Esp3ra/2026-Moble-2.5th-Team-Project-/docs/breadboard-power-example.png

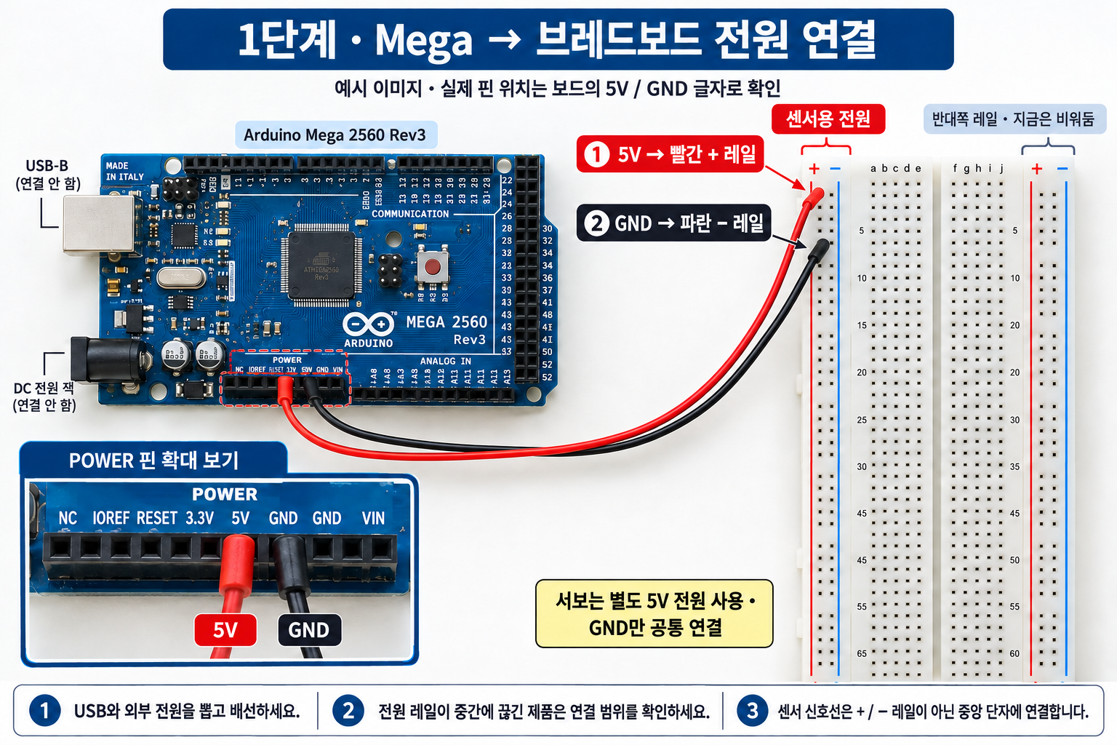
docs/breadboard-power-example.png
