Esp3ra/2026-Moble-2.5th-Team-Project-/artifacts/temperature-stop-dashboard.png

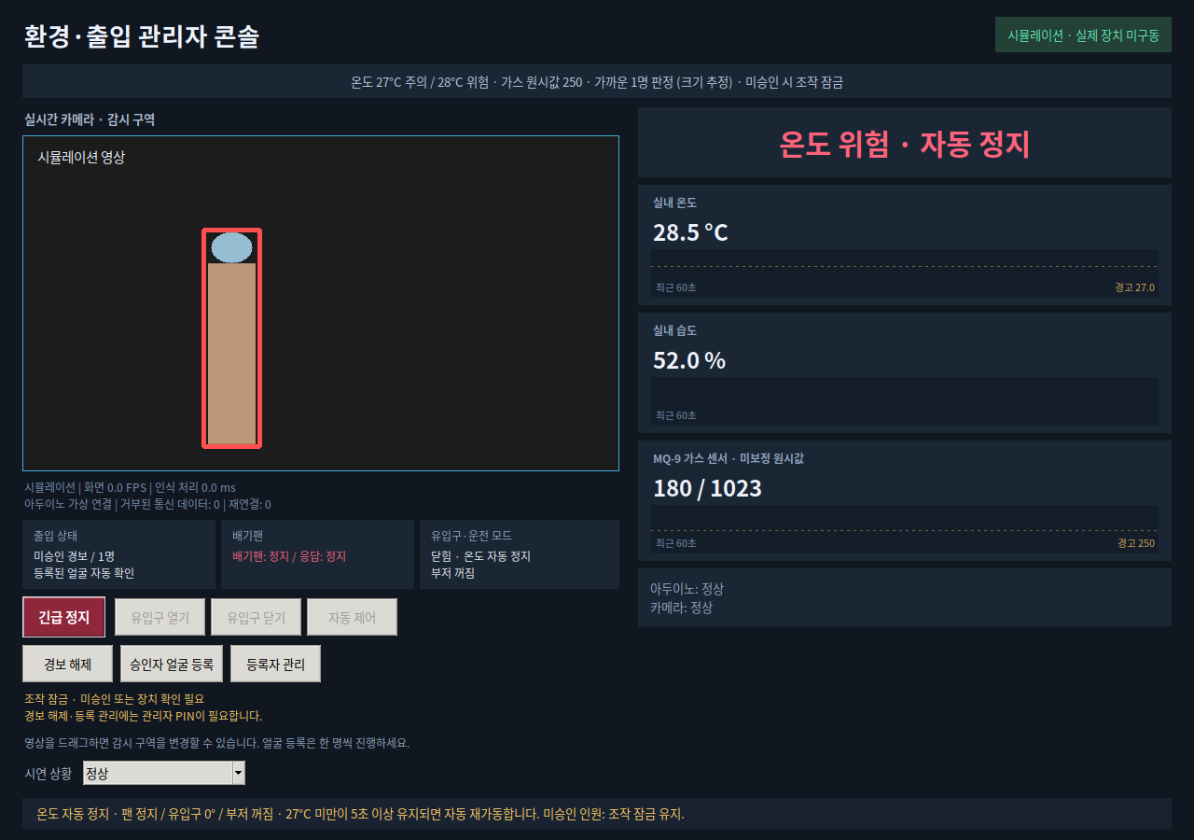
artifacts/temperature-stop-dashboard.png
