Esp3ra/2026-Moble-2.5th-Team-Project-/docs/VALIDATION.md

# 소프트웨어 검증 결과

## 현재 버전: 온도 자동 정지·복귀 (정책 6, 2026-10-15)

- 자동 테스트 **123개 통과**: 28°C 자동 정지, 27°C 미만 5초 유지 후 복귀, 재상승·센서/통신 이상 시 복귀 대기 재설정, 수동 긴급 정지·장치 오류 정지 유지, 가스·미승인 동시 발생, MCU와 호스트의 정지 응답 구분을 포함한다.
- Mega 컴파일·업로드와 정책 6 텔레메트리 확인 완료. Flash 24,578 bytes, 전역 RAM 1,913 bytes.
- 실제 보드 명령 시험: 기본 운전, 온도 자동 정지 출력, 미승인 잠금과 동시 정지, 운전 복귀, 수동 정지, 통신 중단 시 차단을 확인했다. 프레임 오류 0개. 이 시험은 명령·출력 응답 검증이며 실제 가열로 임계값을 넘기는 시험과 구분한다.
- 실제 센서·카메라·명령 응답 30.1초 관찰: 상태 30개, 오류·추가 거부 패킷·재연결 모두 0개. 수동 긴급 정지 상태에서 관찰했다.
- [자동 테스트](../artifacts/temperature-stop-tests.log), [출력 시험](../artifacts/temperature-stop-serial-result.json), [연결 관찰](../artifacts/temperature-stop-live.json), [합성 화면](../artifacts/temperature-stop-dashboard.png).
- DHT11 값이 튀는 물리적 원인은 미확정이다. 아래 항목은 이전 버전의 검증 이력이며 현재 동작은 [운영 안내](VENTILATION.md)를 따른다. 과거 전체 진단 원본은 Jetson에 보관하고, GitHub에는 개인정보 검토를 마친 최신 기록만 포함한다.

## 2026-10-15 부저 음량 감소

- 사용자의 음량 감소 요청에 따라 현재 ventilation 부저를 Timer3 구동으로 변경했습니다. 17% 듀티 시험에서 여전히 크다는 사용자 피드백을 받아 **5% 듀티**로 추가 감소했습니다. 사이렌 주파수와 경보 패턴은 유지합니다. 전기적 기본 주파수 성분의 이론적 진폭은 원래 50% 듀티의 약 16%이며 실제 체감 음량이나 dB 측정값은 아닙니다.
- 자동 검사 **102개 통과** (`quiet-buzzer-tests.log`). 새 검사는 100~8000Hz의 주파수 오차·펄스 폭, 실제 타이머 코드의 정지·재시작, 재설정 시 카운터 초기화, 부저 외 포트 비트 보존, Servo compare A 인터럽트 미사용을 확인합니다. 실제 MCU의 물리 파형을 계측한 검사는 아닙니다.
- Mega 빌드·업로드 완료: flash 23,836 bytes, static RAM 1,823 bytes (`quiet-buzzer-build.log`, `quiet-buzzer-upload.log`).
- 실제 부저를 3초간 시험했습니다. D10 OFF·D9 CLOSED를 유지한 상태에서 명령 응답을 확인했습니다 (`quiet-buzzer-serial.json`). 첫 17% 설정은 사용자에게 여전히 크게 들렸습니다 (`quiet-buzzer-serial-17pct.json`). 추가로 낮춘 **5% 설정은 사용자가 “이제 적당함”으로 확인**했습니다.
- 재연결 중 카메라 장치가 video0에서 video1로 바뀌어 첫 연속 검사에서 영상 연결에 실패했습니다 (`quiet-buzzer-live-before-camera-fix.json`). 운영 설정을 해당 USB 카메라의 `/dev/v4l/by-id/…-video-index0` 경로로 바꿔 장치 번호 변경에 대응합니다.
- 프로그램은 `--start-stopped`로 다시 열어 기존 긴급 정지를 유지합니다. 이 시작 옵션은 시뮬레이션에서 D10 OFF·D9 CLOSED·부저 OFF로 확인했습니다. 수정 후 실제 카메라·센서·명령 응답을 **30.1초** 확인했고 오류·거부 패킷·재연결이 모두 0개였습니다 (`quiet-buzzer-live.json`). 프로그램 재시작 후 저장된 얼굴로 AUTHORIZED 판정이 다시 발생하는 것도 기록에서 확인했습니다.

## 2026-10-15 관리자 콘솔·얼굴 승인·정책 버전 3

- 바탕화면 요청 파일의 네 가지 자동 상태, 정상 D9 0°, 경고 D9 90°, 미승인 초록/빨강, 동시 주황/빨강, 긴급 정지 D9 0°·D10 OFF를 반영했습니다. 관리자 UI는 한글, LCD는 영어입니다.
- 자동 검사 **101개 통과** (`artifacts/admin-tests.log`): 등록 데이터 재로드·삭제·저장 실패 보존, 품질 표본 등록, 모든 인원 확인, 얼굴 교체·추가 인원·오래된 영상 승인 차단, 경보음 해제와 새 원인 재경보, 수동 개폐·자동 복귀·긴급 정지, 기존 통신·카메라·SSD 회귀 검사 포함.
- 실제 Tk 위젯 검사 통과: 한글 PIN 확인/취소, 미승인 잠금, 경보 해제 버튼 활성, 유입구 닫기·얼굴 등록·관리 버튼, 센서 그래프와 잘못된 데이터의 끊김. `admin-ui-check.log`, `admin-ventilation-gui-check.log`, `admin-general-gui-check.log`. 화면 캡처는 시뮬레이션입니다.
- AVR 컴파일 통과: flash 25,014 bytes, static RAM 1,834 bytes. 실제 Mega 업로드 완료 (`admin-firmware-build.log`, `admin-firmware-upload.log`).
- 실제 Mega 출력 순서 시험 통과: ARM, 정상 저속, 미승인 저속, 환경 고속, 동시 고속, 경보음 해제, 긴급 정지, 수동 열기·닫기, 자동 복귀, 오류 정지. 모든 단계에 5회 이상 일치 ACK, 잘못된 프레임 0개, 명령 중단 시 MCU 독립 정지 확인. `admin-serial-result.json`. 이 결과는 출력 명령·응답 검증이며 이번 버전의 LED 색·축 움직임 육안 확인을 대신하지 않습니다.
- 실제 관리자 화면 + 센서 + GPU 카메라 **60.5초**, 상태 60개, 건강 상태 오류 0개, 추가 거부 패킷 0개, 추가 재연결 0개 (`admin-live-result.json`). 해당 구간은 미승인 상태였고 LOW/OFF 명령과 응답이 기록됐습니다.
- 위 구간 이후 14:46:57 카메라 작업이 한 번 재시작됐고 14:47:11 자동 복구됐습니다. 해당 로그만으로 종료 원인을 특정할 수는 없습니다. 복구 후 추가 **60.2초** 검사에서 오류·통신 거부·재연결 0개 (`admin-live-followup.json`), 긴급 정지 D10 OFF 유지가 확인됐습니다. 전체 실행에 카메라 중단이 전혀 없었다는 의미는 아닙니다.
- 사람+얼굴 GPU 모델을 켠 헤드리스 카메라 20초: 640×480, 영상 수신 **29.61fps**, 분석 **12.12회/초**, 분석 중앙값 **67.71ms** (`admin-face-camera-check.json`). 실제 Tk 표시 FPS 및 얼굴 인식 정확도 측정과 구분합니다.
- 사용자가 **얼굴 등록 완료 후 자동 승인**, **LCD 영어 상태와 LED·서보 동작 일치**를 확인했습니다. 실시간 상태에서도 AUTHORIZED가 확인됐습니다. 등록자 1명의 DB 파일(권한 0600)을 별도 Python 프로세스로 다시 읽어 저장 상태를 확인했습니다. 전체 운영 프로그램을 재시작한 뒤의 실물 자동 승인은 아직 재시험하지 않았습니다. 기록: `artifacts/admin-user-acceptance.json`. 등록 원본 사진을 저장하지 않으며 등록 DB와 PIN은 배포 ZIP에서 제외합니다. 얼굴 임계값의 실제 환경 오승인·오거부율이나 사진/영상 위조 방지는 검증하지 않았습니다.

검증일: 2026년 10월 14일. NVIDIA Jetson Nano B01, Ubuntu 18.04.6, ARM64, L4T 32.7.1 환경에서 실행했습니다.

| 항목 | 결과 |
|---|---|
| 자동 테스트 | 73개 통과. 경보·승인·시리얼·카메라 복구, SSD 관련 모의 테스트, 실제 C++ 출력 정책 및 bench 10초 제한·프로필 분리·PIN 저장·ACK 유효기간 테스트 포함 |
| 실제 Tk 화면 | 시뮬레이션 입력으로 정상 → 시작 → 침입 → 차단 → 임시 승인 → 명시적 재시작 흐름 통과 |
| Arduino 기본 펌웨어 | 최신 production 기본 설정 CLI 컴파일 통과. 플래시 16,372바이트, 전역 RAM 1,283바이트. 미확인 출력은 비활성 |
| 이전 출력 진단 단계의 활성화 빌드 | IR 제외, 회전 서보·2kHz 부저 포함 컴파일 통과. 당시 플래시 20,704바이트, 전역 RAM 1,387바이트. 이 기록은 최신 bench 빌드가 아님 |
| Arduino 실물 연동 펌웨어 | 최신 bench 빌드·USB 업로드 통과. 플래시 22,212바이트, 전역 RAM 1,472바이트. MCU 독립 10초 제한, DHT/LCD 작업 후 명령 수신 적용 |
| Arduino 센서 진단 | IDE로 실제 Mega 업로드 통과. 플래시 13,548바이트, 전역 RAM 729바이트. IR과 출력 비활성 |
| 실물 센서·LCD | 첫 수신 DHT11 약 26.4°C / 25.7–25.8% RH, A0 31–32, LCD 주소 0x27. 사용자가 LCD 글자 표시 확인 |
| IR 제외 후 재확인 | DHT11 25.4°C / 28.5% RH, A0 36, LCD 0x27, IR 미사용 패킷 수신. A0 수신은 가스 검출 검증이 아님 |
| RGB 실제 출력 | 사용자가 공통 음극·내장 저항칩 확인. 빨강 → 초록 → 파랑 → 노랑 → 꺼짐 모두 사용자 확인으로 통과. 이후 센서 진단 복구·수신 확인 |
| 부저 직류 시험 | 5V·GND·D28 배선 사용자 확인 후 HIGH/LOW 각 2.5초 출력. 사용자는 두 단계 모두 무음이라고 답함. 정상 동작으로 판정하지 않음 |
| 부저 주파수 시험 | 1kHz/2kHz 각 2.5초 출력에서 사용자 소리 확인. 운영 코드에 2kHz 구동 반영. 센서 진단으로 복구 완료 |
| 일반 SG90 D9 | 외부 5V 2A 공급 사용자 확인. 90 → 75 → 105 → 90도 이동·복귀 사용자 확인, 시험 중 예상치 않은 Mega 재시작 없음 |
| SG90 360 D10 | 1600µs 1초 → 1500µs 1초, 세 번 반복. RUN 동안 연속 회전하고 STOP에서 그 위치에 멈춘다고 사용자 확인. 정지·구동값 코드 반영 |
| 동시 구동 전원 점검 | 최종 10초: 백라이트 ON·RGB 흰색·2kHz 부저·D9/D10·카메라/GPU 동시 실행. 부하 중 53프레임, 재시작·센서·I2C 오류 0회. 사용자가 두 서보 실제 움직임과 LCD·부저 안정성 확인. 외부 전압·전류는 미측정 |
| Arduino IDE | 공식 1.8.19 ARM64 설치·GUI 실행, AVR 1.8.6 및 기존 라이브러리 연결. 시작 직후 RSS 약 144MiB, 힙 최대 256MiB, 컴파일 1개씩 |
| GPU 엔진 | 이 Nano에서 TensorRT 8.2.1로 YOLOv5n FP16 320×320 엔진 생성 완료 |
| 실제 GPU 추론 | 공식 예제 사진에서 사람 2명, 빈 이미지에서 0명 검출. 워밍업 후 5회 처리 중앙값 약 51.5ms |

GPU 측정은 CPU 전처리·후처리를 포함한 정지 이미지 처리 시간입니다. 실시간 카메라 FPS나 현장 검출 정확도를 측정한 값은 아닙니다. `artifacts/gpu-check.json`에 상세 수치를 기록했습니다.

2026-10-14 USB `Global Shutter Camera`가 `/dev/video0`에 연결된 것을 확인했습니다. V4L2 캡처는 실제 640×480 YUYV로 협상됐고 60프레임에서 읽기 오류가 없었습니다. 기존 카메라 작업 프로세스와 TensorRT GPU를 함께 사용한 75초 시험은 383프레임, 작업 프로세스 재시작 0회, 약 5.10fps, 추론 처리 시간 중앙값 약 38.03ms였습니다. 실제 영상에서 사람 검출 박스를 확인했습니다. 이 시험은 현장 검출 정확도나 신원 인증 검증을 뜻하지 않습니다. 상세 결과는 `artifacts/camera-live-validation.json`에 있습니다.

카메라만 확인하려면 `DISPLAY=:0 python3 scripts/camera_check.py --preview --seconds 0`을 사용합니다. Q/Esc 또는 창 닫기로 종료합니다. 이 도구는 Arduino 포트를 열거나 장치에 명령을 보내지 않으며, `--save-frame`을 지정한 경우에만 영상을 한 장 저장합니다. 기본 20초 시험 결과는 `artifacts/camera-live-check.json`에 기록합니다.

Mega USB 업로드, DHT11, LCD 실제 표시, RGB 네 색과 꺼짐, 주파수 신호로 구동한 부저 소리, D9 일반 SG90의 작은 각도 이동을 확인했습니다. D10 회전·정지 시험도 통과했습니다. 환기구 기구 각도, 가스 보정과 실제 장치 차단 통합 시험은 남아 있습니다. 센서 기록은 `artifacts/hardware-first-read.json`, `artifacts/hardware-ir-disabled-read.json`, `artifacts/hardware-after-rgb-read.json`에 있습니다. 출력 시험 기록은 `artifacts/rgb-check-sequence.json`, `artifacts/buzzer-check-sequence.json`, `artifacts/buzzer-tone-sequence.json`, `artifacts/servo-first-check-sequence.json`, `artifacts/servo-one-second-sequence.json`, 현재 상태는 `artifacts/hardware-commissioning-status.json`에 있습니다.

승인 기준은 관리자 임시 승인으로 준비되어 있습니다. 이 검증에는 얼굴 신원 인식이나 RFID 인증이 포함되지 않습니다.

## 실제 소프트웨어 연동 및 창 입력 복구

Mega에는 `mega_controller`의 bench 펌웨어를 업로드했습니다. 실제 DHT11·MQ-9 원시값·LCD·카메라/GPU와 운영 화면을 연결했고, 사용자 PIN 최초 설정과 인원 승인 실행을 확인했습니다. 초기 화면은 키보드는 동작하지만 마우스 클릭이 전달되지 않았습니다. Unity/Compiz 창 관리자를 재시작한 뒤 사용자가 정상 클릭을 확인했으며 PIN은 유지됐습니다.

초기 연동에서는 약 50초마다 ACK 시간 초과가 반복됐습니다. DHT 읽기에 더해 LCD 갱신도 센서 보고 전에 끝내도록 바꿔, 호스트 명령이 들어올 때 MCU가 긴 주변장치 작업을 하지 않도록 수정했습니다. 이후 첫 120초 관찰에서는 재연결은 없었으나 거부 패킷 5개와 일시적인 MCU 통신 경보가 있었습니다. 해당 한 차례의 직접 원인은 확정하지 못했으며 기록을 `artifacts/integration-live-before-final-check.json`에 보존했습니다. 패킷 거부 사유 로그도 추가했습니다.

마지막 120.3초 재관찰은 상태 기록 109개 모두 시리얼 정상·카메라 최신이었고, 새 거부 패킷 0개, 재연결 0회, 오류 상태 0개였습니다. 결과는 `artifacts/integration-live-result.json`에 있습니다. 미승인 상태에서 DANGER·장치 OFF 응답을 유지했습니다. 10초 제한은 호스트와 실제 MCU C++ 정책의 자동 시험으로도 확인했습니다. 현장 전압·기구 부하·가스 보정의 완료를 뜻하지 않습니다.

최종 호스트에는 UI 명령 생성이 멈춰 대기 중인 명령이 없어도 오래된 ACK를 정상 연결로 표시하지 않도록 보완했습니다. 회귀 테스트를 포함한 자동 테스트 73개가 통과했습니다.

초기 START 시도에서 경보 해제 필요 팝업을 확인했습니다. 직전 승인 후 2명 검출로 DANGER가 된 기록이 있어 이 시도는 서보 고장으로 판정하지 않았습니다. 사용자에게 인원 승인과 장치 시작에 같은 PIN을 각각 입력하는 순서를 안내했습니다.

이후 22:56:50 인원 승인 → 22:56:52 NORMAL → 22:56:55 START 수락 → 약 10초 RUN 응답 → OFF 응답의 실제 운영 흐름을 확인했습니다. 사용자가 **승인 후 SG90 360이 실제로 약 10초 회전한 뒤 멈췄음**을 확인했습니다. 22:57:20에는 30초 인원 승인이 만료돼 DANGER·OFF를 유지했습니다. 기록은 `artifacts/integration-start-observation.json`에 있습니다. 이 기록의 종료 시점은 약 1초 간격의 출력 응답이며 축 위치 센서 측정은 아닙니다. 구동 중 새 미승인 인원 진입으로 실제 축이 정지하는 별도 현장 시험과 기구 부하 검증은 남아 있습니다.

## 동시 구동 시험의 범위와 수정

최종 유효 시험은 `artifacts/power-check-result.json`의 **10초 무부하 시험**입니다. 각 서보는 1초 구동·1초 정지를 다섯 번 반복했고, RGB 세 채널과 2kHz 부저·LCD 백라이트는 계속 켰습니다. 카메라·GPU는 부하 중 53프레임을 처리했고 전체 관찰 처리율 약 5.23fps, 추론 중앙값 약 34.82ms였습니다. Mega 재설정·USB 끊김·온습도 오류·I2C 시간 초과와 새 커널 전원 경고는 관찰되지 않았습니다. 사용자가 두 서보의 실제 움직임과 LCD 밝기·부저 소리의 안정성을 확인했습니다. 시험 뒤 `hardware_check`로 복구했고 카메라 전용 미리보기를 다시 열었습니다.

앞선 30초 시험은 나중에 사용자가 서보 전원선이 빠져 있었다고 알려 주어 **서보 부하를 포함한 전원 검증에서 제외**했습니다. 기록은 `artifacts/power-check-30s-servo-disconnected-result.json`에 남겼습니다. 이후 첫 10초 시도에서는 DHT 읽기 시점과 겹쳐 잘못된 통신 명령으로 정지했습니다. DHT 라이브러리는 읽는 동안 인터럽트를 잠시 막으므로, 진단 도구의 여러 글자 PING을 한 바이트 하트비트로 변경했습니다. 정확한 손실 원인은 단정하지 않으며, 수정 후 위 10초 시험은 완료됐습니다. 시작 시 LCD 탐색에는 대기·최대 3회 재시도를 추가했고 최종 시험에서는 첫 탐색에 응답했습니다. 구동 중 I2C 오류는 계속 즉시 정지 조건입니다.

현재 결과는 **짧은 무부하 동시 구동에서 이상 징후가 없었다는 뜻**입니다. 서보 외부 5V 전압·전류, 실제 환기구나 시연 기구 부하의 시동·정지 전류는 측정하지 않았습니다. 따라서 5V 2A 전원에 모든 부하 조건에서 충분한 여유가 있다고 인증한 것은 아닙니다. [NVIDIA 전원 관리 안내](https://docs.nvidia.com/jetson/l4t/Tegra%20Linux%20Driver%20Package%20Development%20Guide/power_management_nano.html)의 저전압·과전류 경고도 새 커널 로그에서 확인했으나 없었습니다. Jetson의 입력 전압 측정 파일은 현재 계정에 읽기 권한이 없으며 서보 외부 전압도 측정할 배선이 없습니다.
# 2026-10-14 연속 환기 변경 검증

`ventilation` 프로필의 환경 우선·동시 주황/빨강 400ms 교대·독립 설정 잠금·STOP 우선 동작을 추가했습니다. Python 및 실제 C++ 정책 회귀 테스트 86개가 통과했습니다. 기본 production, bench, ventilation 펌웨어 모두 컴파일됐으며 ventilation 업로드를 완료했습니다. 실제 Tk 위젯으로 교대 색 표시·잠금·ROI 조작 차단·관리자 승인 후 복구를 검증했습니다.

실제 Mega에 정상 LOW, 미승인 LOW, 환경 HIGH, 동시 HIGH, 동시 경보 중 STOP, FAULT를 보낸 시험에서 각 단계 출력 ACK가 일치했고 프레이밍 오류는 0개였습니다. 하트비트를 중단하면 3초 후 COMM_ERROR/OFF가 유지됐습니다. 이는 명령·응답 검증이며 LED 빛과 실제 회전 속도 검증을 대신하지 않습니다.

첫 출력 시험에서는 사용자가 빨강만 보았고 속도 변화는 보지 못했다고 답했습니다. 23:40:45 Mega USB 분리로 다음 관찰이 중단됐습니다. 재연결 후 LOW 10초 → 환경 HIGH 10초 → 동시 HIGH 20초로 다시 시험했고, 사용자가 **주황/빨강 교대 점멸과 확실한 회전 속도 증가를 모두 확인**했습니다. 이 재시험에서도 각 단계 ACK 일치와 프레이밍 오류 0개를 확인했습니다. 첫 기록은 `ventilation-serial-first-result.json`에 별도로 보존했습니다.

검증 파일: `artifacts/ventilation-tests.log`, `artifacts/ventilation-gui-check.log`, `artifacts/ventilation-serial-result.json`, `artifacts/ventilation-live-result.json`. 현재 시연 제어표는 [연속 환기 안내](VENTILATION.md)를 따릅니다.

실제 앱 관찰 중 승인된 사람이 사라지는 순간의 빈 구역 확인 대기(`UNKNOWN`)를 카메라 오류로 판단해 팬이 멈추는 문제를 발견했습니다. 연속 환기 모드에서는 최신 영상의 인원수 0명 확인 대기를 `CLEARING`으로 구분해 팬을 유지하고 설정만 잠그도록 수정했습니다. 승인된 인원이 떠나는 경우와 실제 카메라 단절을 구분하는 회귀 테스트를 추가했습니다.

수정 후 최종 실제 관찰은 **120.3초 / 111개 상태 기록**, 오류 상태 0개·새 거부 패킷 0개·재연결 0회로 통과했습니다. NORMAL과 DANGER(미승인)에서 팬 LOW 명령을 유지했으며 GPU 추론 평균은 약 35.13ms였습니다. 최초 LOW 명령 직후에는 직전 OFF ACK가 표시될 수 있고 다음 ACK에서 LOW로 전환됩니다. 수정 전의 카메라 확인 대기 오판 기록은 `artifacts/ventilation-live-before-clearance-fix.json`에 보존했습니다. 팬 속도 증가는 앞선 10초/10초 비교 시험에서 사용자가 육안으로 확인한 결과이며 RPM 계측은 아닙니다.
# 2026-10-15 카메라 30fps 표시 변경

기존 실제 카메라는 640×480 YUYV, 10fps 요청에서 약 5fps였습니다. 같은 장치에서 20fps 요청은 약 10fps였으며 320×240으로 줄이는 것만으로는 캡처 속도가 증가하지 않았습니다. GPU를 포함한 직렬 처리 비교에서는 640×480 약 15.73fps, 320×240 약 15.82fps였습니다. 이 수치는 전체 운영 화면의 표시 속도와 구분합니다.

60fps MJPEG 요청으로 640×480 실제 캡처 약 29.71fps를 확인했습니다. 카메라 읽기와 GPU 추론을 분리했고, 프리뷰 시각 `frame_at`과 판정 영상 시각 `camera_at`을 분리했습니다. 카메라가 계속 움직여도 AI 판정이 오래되면 카메라 오류로 차단하고 작업 프로세스를 복구합니다. 이 조건과 느린 추론 중 캡처 연속성을 포함한 자동 테스트 **88개**가 통과했습니다.

화면에서는 PNG 압축·base64를 없애고 RGB/PPM으로 변환합니다. 별도 변환 시험의 중앙값은 75.30ms에서 3.24ms로 줄었습니다. 실제 Canvas 이미지를 매 프레임 교체하는 추가 병목도 확인해 기존 이미지를 갱신하도록 바꿨습니다. 동일 영상 중복 변환을 생략하고 표시 FPS를 추가했습니다.

실제 Tk 화면에서는 640×480 입력으로 최적화 전 약 19fps, 이미지 재사용 이후 약 27fps였습니다. **320×240 입력**에서는 짧은 비교 시험에서 약 **29.66fps**를 확보해 당시 설정으로 선택했습니다. 같은 GPU 모델을 사용하며 해상도 감소로 화면 선명도는 낮아집니다. 사람 검출 빈도는 화면 FPS와 별도로 기록합니다.

기록은 `camera-render-benchmark.json`, `camera-mode-comparison.json`, `camera-capture-60.json`, `camera-decoupled-check.json`, `camera-dashboard-live-check.json`, `camera-preview-tests.log`에 있습니다. 카메라 점검 도구는 Arduino를 열지 않았으며, 이 변경에서 물리 출력 배선·MCU 제어 정책을 바꾸지 않았습니다.

최종 320×240 실제 Tk 화면 시험은 **60.04초 / 1774프레임 / 평균 29.53fps**였습니다. 5초 구간별 28.6~30.2fps, 프레임 간격 95백분위 38.67ms, 카메라 작업 프로세스 1회 시작·재시작 0회·오류 0개였습니다. AI 판정은 별도로 약 27.90fps, 처리 시간 중앙값 33.12ms, 관찰한 판정 영상 최대 지연 0.208초였습니다. 이 숫자는 실제 표시된 새 영상의 빈도이며 콜백 호출 횟수로 계산하지 않았습니다. 정확히 매 순간 30.00fps를 보장한다는 뜻은 아닙니다.

# 2026-10-15 사용자 요청: 640×480으로 변경

기본 캡처 해상도를 **640×480**으로 올렸습니다. MJPEG·60fps 전송 요청·화면 기준 30fps와 카메라/GPU 분리 처리는 유지했습니다. 기본 프로필과 연속 환기 프로필에 새 해상도가 적용되는지 설정 로더로 확인했습니다.

실제 Tk 통합 화면과 GPU 감지를 함께 실행한 **30.06초 / 789프레임** 시험은 평균 **26.21fps**, 5초 구간별 **25.4~27.4fps**였습니다. AI 판정은 별도로 24.48fps, 추론 시간 중앙값 37.35ms, 판정 영상 최대 지연 0.197초였습니다. 카메라 오류·재시작은 없었지만 30fps 근접 기준에는 미달하여 결과의 `passed`는 `false`입니다. 요청한 해상도를 유지했으며, 30fps 고정으로 검증된 설정이라고 표시하지 않습니다.

현재 결과는 `artifacts/camera-dashboard-live-check.json`, 이전 320×240 결과는 `artifacts/camera-dashboard-320-final.json`에 보존했습니다. 이번 시험에서 Arduino 포트는 열지 않았습니다.

# 2026-10-15 운영 화면 한글화

Jetson 운영 화면의 제목·버튼·상태·팬 속도·인원 승인·경보 원인·연결 상태·시연 상황 선택을 한글로 바꿨습니다. PIN 입력창은 입력값을 가린 채 한글 확인·취소 버튼과 Enter/Esc를 지원합니다. 아두이노 통신 코드와 점검 로그의 상태 값은 기존 형식을 사용하며 화면에서 한글로 표시합니다. 센서 기준, 승인 조건, 장치 제어 정책과 카메라 설정은 동일합니다.

Jetson의 Python 3.6에서 발견한 폰트 설정 API 호환 문제를 수정했고, Noto Sans CJK KR로 한글 글꼴을 적용했습니다. 기존 자동 테스트 **88개**가 통과했습니다. 실제 Tk 위젯을 사용한 일반 모드·연속 환기 모드 검증과 한글화 점검에서는 시연 상황 10개 선택, 두 명 승인 차단과 한글 오류 메시지, PIN 가림·확인·Esc 취소, 기본 오류창의 한글 확인 버튼, 버튼 영역, 동시 경보의 설정 잠금·색상 교대 및 긴급 정지를 확인했습니다. 이 화면 점검은 모두 시뮬레이션 입력으로 실행했습니다.

검증 기록은 `artifacts/korean-ui-tests.log`, `korean-ui-check.log`, `korean-ventilation-gui-check.log`, `korean-general-gui-check.log`이며 한글 화면은 `artifacts/korean-dashboard.png`입니다. 현재 Mega는 사용자 요청으로 D9 90도 단독 시험을 마친 `d9_position_check` 펌웨어 상태입니다. 실제 전체 회로 연동 전에는 `build/mega-ventilation`의 운영 펌웨어 복원이 필요합니다. 이번 한글화 작업에서 PIN 설정 파일은 수정하지 않았습니다.
