Esp3ra/2026-Moble-2.5th-Team-Project-/(commit log)

2026-10-15 docs: initialize Jetson Nano and Mega project overview
2026-10-15 feat: import complete Jetson Nano and Mega monitoring project
    Include the Korean dashboard, nearest-person face authorization, Mega firmware,
    28 C automatic stop and normal-temperature recovery, hardware diagnostics,
    SSD tools, wiring documentation and 123-test validation evidence.
    Keep local PINs, face registrations, raw runtime data and generated model/tool
    files out of source control. Document reproducible installation from manifests.
